pedrominatel/esp-rust-board/hardware/esp-rust-board/schematic/esp-rust-board.pdf

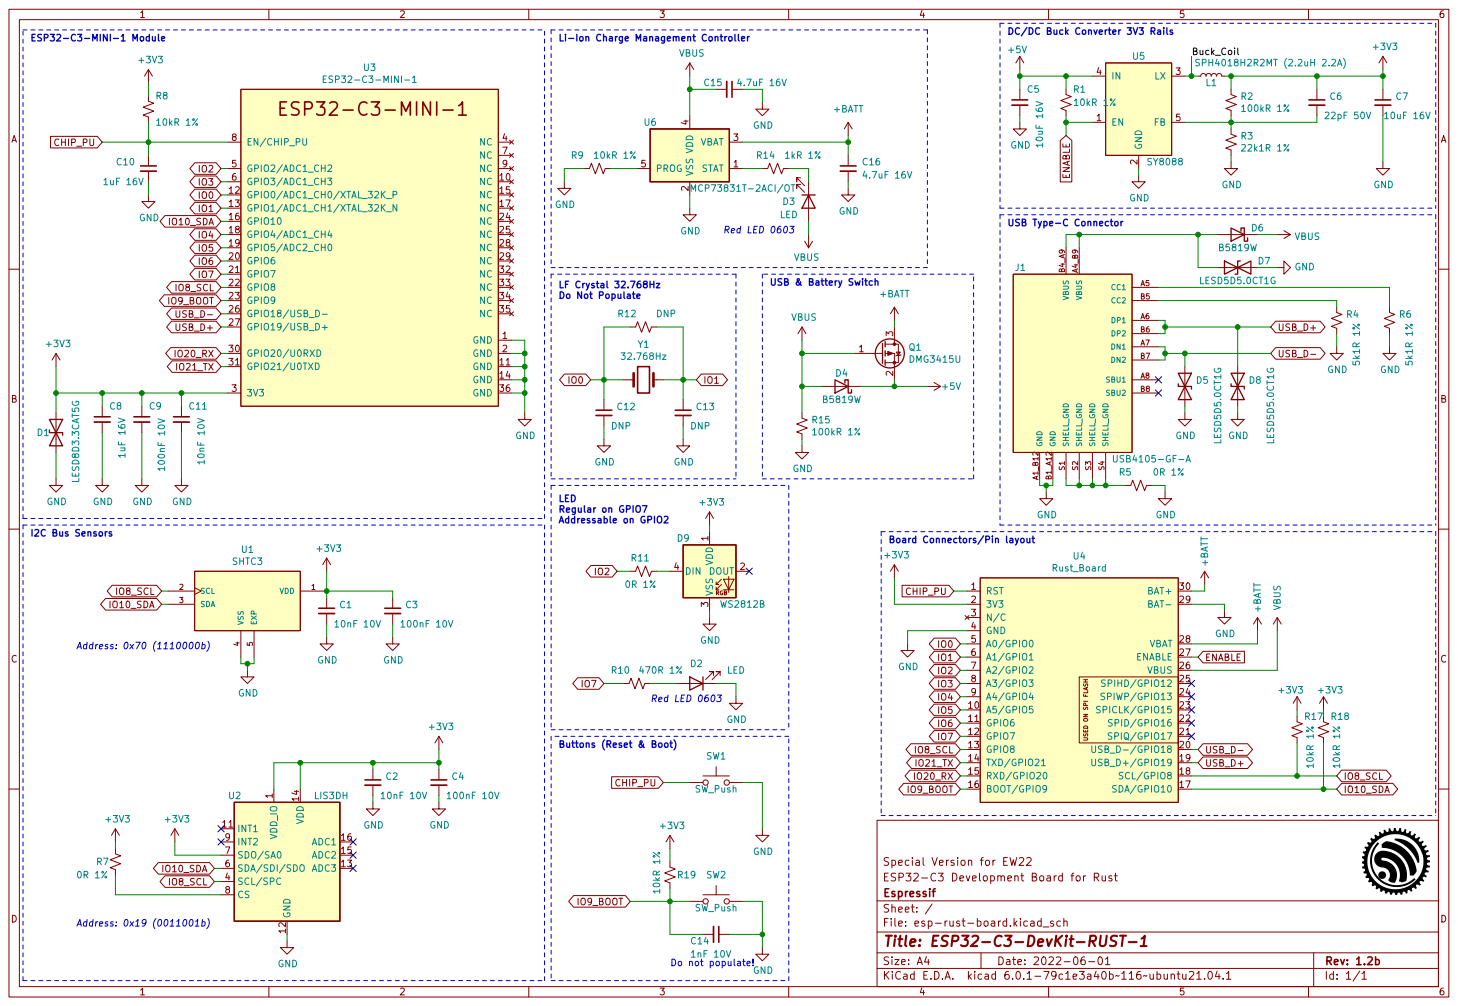
[picture p1: page 1]

10nF 10V GND
Regular on GPIO7 Addressable on GPIO2 Address: 0x19 (0011001b)

Board Connectors/Pin layout

ESP32-C3 Development Board for Rust
File: esp-rust-board.kicad_sch Sheet: / Espressif

Id: 1/1 Title: ESP32-C3-DevKit-RUST-1
