pedrominatel/esp-rust-board/(commit log)

2022-01-27 Review on the DRC warnings and labels (#27)
    * [HW] Added new schematic
    * [HW] WIP on the schematic
    * [HW] Added PCB design file and schematic in PDF file
    * [HW] Buck position changed and Rust Logo removed from schematic and PDF
    * [HW] Added new setp files for SHTC3 and updates on the PCB and schematics
    * [HW] Added images, PDF and minor fixes
    * Removed some dimension marks
    * [HW] Project converted to KiCad6 and layout in progress
    * [HW] Minor change on the debouncing cap due the Espressif revision
    * [HW] PCB layout WIP
    * [HW] Schematic updated and layout ongoing
    * [HW] README file updated
    * [HW] Files removed
    * [HW] Files sync after the mess
    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
    [esp-rust-board-B_Cu.gbr, esp-rust-board-B_Mask.gbr, esp-rust-board-B_Paste.gbr, esp-rust-board-B_Silkscreen.gbr, esp-rust-board-Edge_Cuts.gbr, esp-rust-board-F_Cu.gbr, esp-rust-board-F_Mask.gbr, esp-rust-board-F_Paste.gbr]
2022-01-27 Gitignore update and backup files removed (#28)
    * [H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
2022-06-01 Added LIS3DH
    [esp-rust-board.kicad_pcb, esp-rust-board.kicad_sch]
